QYS0313/FPGA_RACE_Lingmou/Software/Host_Software/Screenshots/model_detail_pose.png

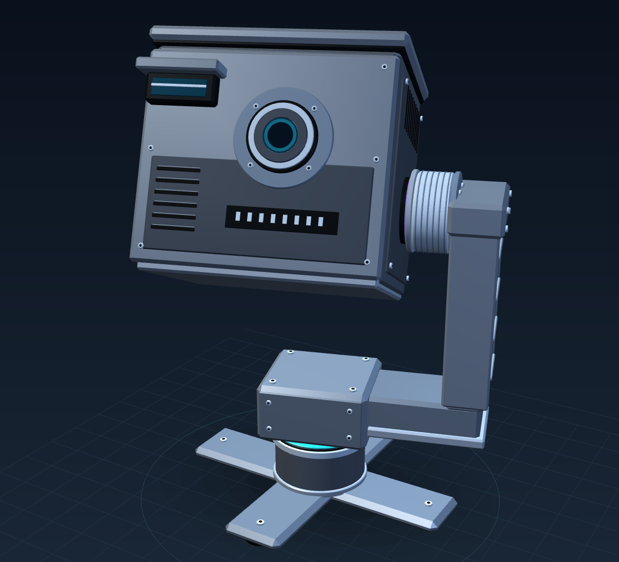
Software/Host_Software/Screenshots/model_detail_pose.png
