QYS0313/FPGA_RACE_Lingmou/Software/README.txt

FINAL FPGA DEMO DELIVERY - 2026-10-30

FPGA_Projects: Video_D1 (D1/A9) and Tracking_D2 (D2/E7), including source projects and final bitstreams.
Host_Software: integrated desktop console with bundled runtime. Start Launch_GUI.cmd.

两个正式工程与上位机已分开整理，目录和文件名使用英文。
工程一 TD 入口：FPGA_Projects/Video_D1/td_project/camera_to_dsi_display.al
工程二 TD 入口：FPGA_Projects/Tracking_D2/td_project/camera_to_dsi_display.al
上位机入口：Host_Software/Launch_GUI.cmd
原开发目录保持原样。未执行烧录、串口连接或电机控制。
SHA256SUMS.json records the packaged files for integrity verification.
