QYS0313/FPGA_RACE_Lingmou/Software/FPGA_Projects/Video_D1/README.txt

Video_D1 / A9

Open td_project/camera_to_dsi_display.al with Anlogic TD 6.2.1.
Final verified build: Bitstreams/demo_video.bit
Device: PH1P35MDG324.
Sources and constraints are included. Old generated databases are omitted.
Build_Report.txt records the shipped bit, not a future rebuild.
