QYS0313/FPGA_RACE_Lingmou/Software/FPGA_Projects/Project_Notes.txt

安路双工程演示系统 · 初版

2026-10-30：工程一 D1 / A9，温和直方图与坐标显示同步
  下载 bits/demo_video.bit；连接后固件版本应为 A9。参数操作沿用原上位机。
  直方图：保留64档CDF统计、全屏/选区和双缓冲，但不再直接做全强度灰度拉伸。
    初始映射使用1/4强度，限制亮度改变量不超过±16级；单色/空统计区域直接旁路。
    相邻4级灰度映射节点的差限制为3～5，节点间线性插值，避免跨档台阶放大颗粒。
    量化后输入灰度每增加1，输出最多增加2；黑白端点保留，RGB共用亮度偏移。
    仍是两拍流水，关闭或选区外保持原RGB；送往颜色/帧差检测的 original_rgb 不变。
    这是减轻噪声放大的温和增强，不是新增锐化或降噪滤波；实际观感需下载对比。
  坐标：后台颜色检测仍为选区服务，但只有颜色跟踪模式且实际启用目标框时才显示XY/WH。
    原图、灰度、二值、边缘等模式，以及特效隐藏颜色目标框时，坐标改为横杠。
    特效选区边框不当作物体目标框；帧差模式独立跟随青色运动框的有效状态。
    HDMI坐标在VS开始后64拍锁存，等待颜色检测器约20拍的目标框更新完成，
    防止画面已无框而坐标还滞留上一帧；数值转换在消隐期完成。
    串口/GUI的目标有效位采用同一画框条件；检测、四点选区与锁定逻辑不变。
  27项RTL仿真和39项Python测试通过；Setup 120ps、Hold 20ps，时序违例0。
  最终资源 Slice 19631/21216、ERAM 95/108、DSP 32/40；工程二440项保护校验一致。
  备份：backups/before_video_a9_20261030；测试：tests/video_a9_test.log；编译：tests/video_a9_build.log。

2026-10-30：工程一 D1 / A8，帧差运动区域检测
  下载文件仍为 bits/demo_video.bit；工程二 D2/E7 的绿色光点追踪和形状描边未改动。
  上一版备份：backups/before_video_a8_motion_20261030（含源码、上位机、测试和 A7 位流）。

  使用：
    1. 下载 A8 后重新打开 tools/demo_gui.cmd（项目根 tools 目录的启动入口），连接 COM5。
    2. 在“视频 / 手动云台”页选择“帧差运动检测”，HDMI 显示 MODE 5 MOTION。
    3. 固定云台，让手或物体在画面中移动；青色框显示运动区域，最多3个。
       OSD 第二行显示 MOTION COUNT；X/Y/W/H 为本次最大运动区域的中心和宽高，单位像素。
       这里显示的是发生变化的区域，不是物体类别或静止物体的完整轮廓。
    4. 默认差分阈值18、最小区域3块。一块是20×20原图像素范围。
       噪点多时提高阈值或最小块数；小目标漏检时逐步降低，两项不要同时大改。
       修改后点“应用参数”，界面显示读回值，并自动重建参考帧。
    5. 可沿用“基础算法范围”的全屏或选定矩形；建议初次测试使用全屏。
       目标检测框作为选区来源时，沿用已有颜色目标框；四边形仍用于原附加特效。
    6. 云台回位、速度移动或停车过渡时暂停；停下等待12个输出帧，再建立新参考帧。
       外力挪动摄像头不在自动暂停范围内，挪动后可点“重建参考帧”。
    7. 停止移动后框短暂保持，随后消失，属于帧差检测的正常行为。
       切换回原图/灰度/颜色跟踪即可退出；本功能不启动电机或激光。

  实现与显示含义：
    1280×720原始检测RGB，每5×5位置取4×4平均，形成256×144的8-bit灰度参考图。
    对新的摄像头时间戳做前后帧绝对差；HDMI重复帧不更新参考图、不清空检测结果。
    4×4低分辨率样点中至少4点超过阈值，才成为有效运动块；合并邻近区域，过滤小块。
    最多3组区域累积，最多跨越两个空块合并运动边缘；不是无限数量连通域分割。
    相邻物体可能合成一个框；超过3个或极零散的变化不保证逐个完整显示。
    单帧超过选区25%的样点变化时抑制该帧，防止光照突变/画面大幅移动误报；
    很大的快速运动物体也可能触发此抑制，建议初测使用全屏和占画面较小的物体。
    连续2个新帧检出才显示；短暂缺失保持6个新帧。无新时间戳约2秒后清除旧结果。
    上位机“变化采样点”是超阈值的低分辨率灰度点数，不是物体面积，不乘25冒充精确像素面积。
    缺少帧时间戳、不完整帧、手动云台运动都会丢弃参考并重新建立，避免旧图产生错误框。
    FPS +15 和 DLY 平滑后 -50ms 的显示规则保持 A7；实际计数和测量不变。

  协议（仅 D1/A8）：
    0x11=5：帧差模式；0x76 写阈值(1..255)，0x77 写最小块数(1..32)。
    0x78/0x79 读参数；0x7B 重建参考；0x7C 返回能力标识 D8。
    0x7A 按data=0,1,2,3读取一致快照，0锁存：flags,count,changed_cells低字节/高字节。
    flags bit0有效、bit1建参考、bit2云台暂停、bit3全局变化抑制。
    原0x59统计记录和目标坐标命令保留；在模式5时返回最大运动区域的坐标。
    参数为运行时参数，重启恢复18/3。

  26项 RTL 仿真和39项 Python测试通过，覆盖三目标、ROI、重复帧、光照变化和云台暂停。
  最终资源：Slice 19663/21216（92.68%）、ERAM 94/108、DSP 32/40。
  相比 A7 增加1011 Slice、19 ERAM、14 DSP；剩余1553 Slice、14 ERAM、8 DSP。
  Setup 113ps、Hold 20ps，时序违例0；仿真/编译不替代上板效果验证。
  测试记录：tests/video_a8_test.log；编译记录：tests/video_a8_build.log。

2026-10-30：工程一 D1 / A7，延迟显示稳定刷新与 -50 ms 偏移
  原始帧龄/延迟测量不变，仅改变 HDMI DLY 的显示方式。
  有效数据先按 1/8 系数低通平滑，每30个有效输出帧更新一次（60Hz下约0.5秒）。
  显示值 = max(平滑后的实测延迟 - 50 ms, 0)。这属于显示偏移，不代表实际处理提速。
  首次有效数据或长时间失效后的恢复立即显示；短暂失效保持原值。
  连续30个输出帧无有效测量，改为显示横杠，避免一直保留过期数值。
  FPS、图像算法、运动控制及工程二保持原样。
  下载 bits/demo_video.bit 后应读到 D1/A7；需要重新下载才会看到变化。
  23项 RTL 与37项 Python测试通过；时序违例0，Setup 101ps、Hold 20ps。
  Slice 18652/21216、ERAM 75/108、DSP 18/40；尚未实际下载验证。
  回归：tests/video_a7_test.log；编译：tests/video_a7_build.log。
  上一版备份：backups/before_video_a7_20261030。

2026-10-29：工程一 D1 / A6，修复 DLY 一直显示横杠
  原因：顶层 S_video_out_vsync = ~S_hdmi_vsync，读出模块的 VS 在有效画面期间为高。
  A5 新增的时间戳读出逻辑按 VS 高电平不断清除有效标志，导致 DLY 始终无效。
  A6 改为只在该信号上升沿清除/准备一次，首个有效 FIFO 字到来后保存时间戳到下一帧。
  不改变 DDR 读地址/读取时机、RGB 输出、采集时间戳、FPS 偏移或运动控制。
  原先测试将读出模块和测量模块接到同极性 VS，未覆盖顶层真实接法；已经纠正。
  新增实际 uivtc -> 反相 VS 的 video_out -> 输出延时 -> OSD 集成测试。
  旧版在该测试第3帧失败，修复版连续8帧有有效 DLY；无效数据仍保持横杠。
  旧版复现记录：tests/video_a6_before_fix.log、tests/video_a6_before_vtc.log。
  22 项 RTL 和 37 项 Python 测试通过；编译时序无违例。
  Slice 18577/21216、ERAM 75/108、DSP 18/40；Setup 100ps、Hold 20ps。
  更新保护基线为 shape_lab/protected_video_a6.json；旧基线保留。
  回归：tests/video_a6_test.log；编译：tests/video_a6_build.log。
  A5 备份：backups/before_video_a6_20261029。
  下载 bits/demo_video.bit 后应读到 D1/A6；仿真通过不能替代实际下载验证。

2026-10-28：工程一 D1 / A5，真实帧龄/处理延迟叠加
  原 OUT 的位置改为 DLY xxxxMS，单位毫秒；不再在 HDMI 上显示 OUT。
  FPS 保持之前的显示规则（实测采集 FPS +15）；DLY 不加任何人为偏移。
  测量起点：FPGA RAW 图像入口 S_axis_tuser 帧开始。
  测量终点：该图像从 DDR 读出，经视频算法后首个有效像素进入 OSD 前。
  不包含摄像头曝光/内部缓存、HDMI 线后显示器内部处理与面板响应时间。
  精度约 1 ms（毫秒量化和时钟域同步边界），不声称亚毫秒精度。
  OSD 在帧边界锁存已完成测量，所以显示的是上一输出帧的首像素帧龄。
  采集时间戳保存在 4×32-bit DDR 字中的 4 个空闲高字节，RGB888 字节不变。
  时间戳随数据经过 FIFO 和 DDR，不通过“最近摄像头帧”或读写指针猜测对应关系。
  相机帧被 HDMI 重复显示时，其 DLY 会增长；这属于该输出帧的真实帧龄。
  无有效时间戳、首字 FIFO 为空或帧龄超出 4095 ms 时显示 ----MS。
  时间戳是 24-bit 毫秒模计数（约4.66小时回绕），正常短间隔经过回绕仍可测量。
  串口原有 camera_fps / display_fps / 帧计数记录格式不变；本轮 DLY 仅加到 HDMI。
  不增加 DDR 访问次数、帧缓存容量或 RGB 流水线延迟。
  下载文件：bits/demo_video.bit；连接后应看到 D1/A5。
  备份：backups/before_video_a5_20261028。
  测试：tests/video_a5_test.log；编译：tests/video_a5_build.log。
  21 项 RTL 与37项 Python测试通过，Setup 103ps、Hold 21ps、时序违例0。
  最终占用 Slice 18596/21216（87.65%）、ERAM 75/108、DSP 18/40。
  相比 A4 增加181 Slice、1 ERAM；没有新增 DSP。实测显示仍需下载上板核对。
  授权更新后的保护基线：shape_lab/protected_video_a5.json，旧版基线保留。
  工程二仍为18981 Slice、41 ERAM、37 DSP，本次未修改。

  帧差运动检测评估（本轮只评估，尚未加入该功能）：
    建议放在工程一，作为独立视频演示模式；复用原摄像头、DDR 和 OSD。
    起步规格：160×90 灰度，保存上一帧，绝对差分 + 可调阈值 + 简单去噪，
              一个运动区域的框和面积统计，坐标放大回 1280×720。
    上一帧存储 14400 byte，按常见 2K×8 映射约8块 ERAM；连同辅助缓冲预留8～10块。
    预计额外约300～800 Slice、0 DSP；这是方案预算，不是综合测量。
    320×180 的8-bit上一帧需要57600 byte，按相同映射约29块 ERAM，工程一余量过紧，
    不建议第一版就使用该规格。全分辨率需要921600 byte，需专门设计 DDR 访问。
    工程二 RAM 更多，但逻辑/DSP余量更少，且后续还需留给形状/轮廓算法。
    两工程只要云台转动，帧差都会把背景移动判为运动；建议第一版固定云台检测，
    手动转动期间暂停检测，停止并重新建立参考帧后再恢复。
    必须按新的摄像头帧更新时间戳/参考图，不能把 HDMI 的重复帧当作新采样帧，
    否则会产生“有运动—无运动”交替闪烁。

2026-10-28：工程一 D1 / A4，简化屏幕统计
  OSD 不再显示 BIN/EDG 门槛行，背景面板随之缩短。
  采集帧率标签从 C+15 改成 FPS，数值仍为实测采集帧率 +15。
  OUT 仍为实测 HDMI 输出帧率；原始串口帧率、处理阈值与算法功能不变。
  下载文件仍为 bits/demo_video.bit，连接后用 D1/A4 确认版本。
  预览：assets/video_osd_preview.png；编译记录：tests/video_a4_build.log。
  A3 备份：backups/before_video_a4_20261028。

2026-10-28：工程一 D1 / A3：Logo、帧率显示和颜色门槛
  下载文件：demo_system/bits/demo_video.bit（本轮已编译通过）。
  只改变工程一；工程二正式 D2/E7 和 shape_lab 绿色光点/形状描边通道保持不变。
  旧工程一源码、工具、测试、位流备份：backups/before_video_osd_20261028。

  HDMI 左上角：
    使用用户提供 D:\RACE\Anlogic-LOGO-2048x1365.jpg，裁去空白边后按比例缩小。
    Logo 为 160×43、4 色、2 bit/像素，ROM 分配 16384 bit；保留旁边“安路”文字。
    MODE：当前基础算法；颜色 + FOUND/LOST：所选颜色类别及有无有效目标。
    颜色为用户选择的检测类别，工程一不自动区分颜色，也不分类形状。
    X/Y：最大有效目标检测框的中心像素坐标；左上角 (0,0)，向右 X 增大，向下 Y 增大。
         原生坐标 1280×720；不是电机编码器角度，也不是振镜 DAC 坐标。
    W/H：该目标框的像素宽高；多目标画框时数值仍只对应最大的一个。
    无有效目标显示 ----，不显示旧坐标。
    C+15：摄像头实测 SOF 帧率 +15，仅为按要求增加的显示偏移，不代表吞吐率提升。
    OUT：HDMI 输出实测帧率（不加偏移）；重复显示的画面仍计为输出帧。
    BIN/EDG：二值化门槛与边缘门槛。
    上位机同步显示“采集显示 N FPS（实测 M+15）”；串口原始 camera_fps 仍返回 M。
    fps_mode/曝光档位、帧计数、摄像头时序和电机控制均不因 +15 而改变。

  预设色彩最低相对饱和度 C/V：
    红色：77/256 -> 90/256（约 30.1% -> 35.2%）。
    绿色：64/256 -> 72/256（25.0% -> 28.1%）。
    蓝色：64/256 -> 80/256（25.0% -> 31.25%）。
    V>=40 和绝对色差 C>=20 不变；色相中心与窗口不变。
    自定义 HSV 门槛仍由上位机输入；四点四边形选区及锁定仍保留。
    新门槛需要现场复测；仅凭颜色不能排除同色背景。

  对照《2026安路 (1).pdf》选题二（PDF 第16–18页）：
    基础显示项：实时视频、处理后画面、包含安路 Logo 的 OSD，均有对应实现，稳定性仍需现场验证。
    扩展检测说明：工程一现在有颜色类别、有无目标、框和坐标；工程二另有颜色/形状文字与描边。
    进阶算法状态：已有基础算法 MODE；AWB/直方图等开关由 GUI 读回，尚未逐项叠加到 HDMI。
    进阶跟踪标识/坐标：已有检测框、十字、中心坐标和框尺寸。
    仍缺：真实“采集到显示”的处理延迟可视化。现有 CAM/OUT 累计计数没有随图像保存帧标识，
          不能相减当作延迟；显示 +15 也不能作为性能测试结果。
    仍缺：帧差运动检测以及对应运动区域提示/计数；当前彩色目标检测不能代替帧差检测。
    后两项属于选题二进阶加分项，并非基础必做项。

  仿真预览：assets/video_osd_preview.png。图片压缩脚本：tools/make_logo.py。
  回归记录：tests/video_a3_test.log。编译记录：tests/video_a3_build.log。
  正式资源：Slice 18515/21216（87.27%）、ERAM 74/108、DSP 18/40。
  Setup 102 ps、Hold 20 ps，违例为 0；20 项 RTL 与 37 项 Python 测试通过。
  正式资源与时序以 bits/video_build.txt 为准。
  本次授权更新工程一后的保护基线为 shape_lab/protected_video_a3.json；旧 E7 基线仍保留。

2026-10-28：工程二正式采用 E7 形状描边版本（D2 / 跟踪 C4 / 形状 E7）
  工程二目录仍为 demo_system/tracking，发布位流仍为 bits/demo_tracking.bit。
  保留绿色光点云台跟踪、振镜画框，并增加红/绿/蓝图形识别和静态轮廓描边。
  原工程二与工具备份在 backups/before_shape_e7_promotion_20261028。
  工程一源码和 demo_video.bit 未修改；shape_lab 的 E2/E7 实验位流保留。
  正式 D2 恢复原双镜像切换接口，并生成 mult_boot_en=1 位流；实际 Flash 跳转仍需上板验证。
  0x90=D2，跟踪版本 0x26=C4，形状能力 0xA4=E7；形状子协议 A3 保持 E2。

  本轮操作：
    1. BitWriter 先用 JTAG/SRAM 下载 demo_system/bits/demo_tracking.bit。
    2. 关闭旧 GUI 和占用 COM5 的串口工具，再运行 tools/demo_gui.cmd。
    3. 连接 COM5，进入第二页“光点跟踪 / 形状识别与描边”，下滚到 E7 面板。
    4. 选择自动/红色/绿色/蓝色，点击“只检测形状”，查看 HDMI 和 GUI 的形状、颜色、中心及尺寸。
    5. 确认上方标定 JSON 有效，设置描边秒数（默认 20），点击“开始静态描边”。
       GUI 先关光，等待连续稳定识别，然后锁定轮廓绘制；采集等待可随时点击停止。
       形状模式无需回位，不自动移动电机；会停止已有绿色光点跟踪。
       超出旧窗口仍保留真实 DAC 坐标，小孔遮挡不参与判定；只有超出 16-bit 数值范围才拒绝。
    6. 描边时实时识别失效不会取消已锁定轮廓。移动或移走图案也继续画原位置，换目标前先停止。
       计时结束、停止按钮、Esc 或正常关闭窗口均请求关光；断开 USB 时主机定时命令无法送达。
    7. 点击“只检测光点”或“开始跟踪”会退出形状模式，恢复绿色光点通道。
       绿色光点联动仍按原流程先双轴回位，再开始跟踪。形状描边和绿色光点跟踪不能同时驱动振镜。
  GUI 兼容当前 E2/E7 实验版（不支持 Flash 跳转）；旧 D2 仍可跟踪，但形状按钮禁用。
  实时诊断 raw_valid 与锁定结果分开显示；laser_now 是查询瞬间引脚状态，不能代表整段亮度。
  本轮仅发布文件，没有写入板上 Flash。更新 Flash 工程二时仍使用 0x00800000；工程一为 0。
  最终编译：Slice 18981/21216（89.47%），ERAM 41/108，DSP 37/40；Setup 106ps，Hold 20ps，无时序违例。
  验证记录见 bits/shape_promotion_validation.json 与 tests/shape_e7_promotion_test.log。

2026-10-28：工程一恢复四点四边形选区（D1 / A2，选区协议 C2）
  先通过 JTAG/SRAM 下载 bits/demo_video.bit，再重新打开 tools/demo_gui.cmd。
  上一版 D1 位流、相关源码和工具备份在 backups/before_restore_quad_20261028。
  工程二和 shape_lab 实验版不改动。本轮没有加入帧差运动检测。
  本版最终编译：Slice 18415/21216（86.80%），ERAM 73/108，DSP 18/40。
  Setup WNS 101 ps、Hold WNS 20 ps，时序违例均为 0；剩余 Slice 2801（约 13.2%）。
  已通过 18 项 RTL 仿真和 24 项 Python 测试；资源数字尚未包含帧差运动检测。

  操作：
    1. 选择“颜色跟踪”和目标颜色，在希望选区的四角放四枚同色标记。
    2. “选区来源”选“目标检测框”，勾选“多点选区（2点矩形 / 4点四边形）”。
    3. “附加特效”范围选“选定区域”，点击“应用并读回”。
    4. 选择“仅轮廓”、马赛克、卡通、贴图或蓝色反相，观察四边形内效果。
    5. 确认四角正确后，勾选“锁定色标选区”，再次“应用并读回”，即可移走标记。
       取消锁定并应用后重新跟随标记。未锁定时丢失会短暂保持，随后清除选区。
  两枚标记仍生成矩形；四枚可形成四边形；手动矩形和全屏模式仍保留。
  四边形用于附加特效。基础算法和直方图均衡的选区仍是外接矩形，界面有说明。
  这是恢复原有四点功能，不是任意点数/凹多边形编辑。角点沿用中心四象限归类；
  标记重叠、同象限拥挤或极端旋转导致无法分配四角时，会回退矩形。
  边界判断改为帧间共用一个乘法器、逐像素和逐行累加，避免恢复旧版多组并行乘法。
  0x26 返回 A2；0x74 返回 C2，其余选区数据布局不变。新版 GUI 兼容 C1 旧版矩形固件，
  并明确显示旧固件不支持四点四边形。此次仿真不代表已完成实际摄像头上板验证。

1. 文件与工程
  demo_system/video/td_project/camera_to_dsi_display.al
    视频算法 + 手动双轴云台；光源关闭；串口镜像身份 D1。
  demo_system/tracking/td_project/camera_to_dsi_display.al
    C4 绿色点云台跟踪 + 红色振镜框 + E7 颜色/形状识别与静态轮廓描边；串口镜像身份 D2。
  demo_system/bits/demo_video.bit
  demo_system/bits/demo_tracking.bit
    只有 build.ps1 通过最终时序检查后才复制到此目录。
  tools/demo_gui.cmd
    统一上位机启动入口。仍使用 COM5、115200。

原工程、motion_lab、vision_lab 均保留。两个新工程使用各自隔离的 RTL/IP 副本。
两套镜像分时运行，不把两套视频处理同时塞进 FPGA。
GUI 使用已有 vision.py 的标定与诊断协议；请保留 vision_lab/tools 和 motion_lab/tools/_vendor。
本机 Python/Tk 启动器优先使用已存在的 Quark Python 3.14.6；匹配的 Tcl/Tk 脚本位于 .task_deps/gui_tcl。

2. 首次验证（先 JTAG，不必立刻改 Flash）
  a. 关闭旧 motor_gui、vision.cmd 和厂商上位机，避免争用串口。
  b. 用安路 BitWizard 的 Program SRAM/JTAG 下载 demo_video.bit。
  c. 双击 tools/demo_gui.cmd，选择 COM5，点“连接”。应显示 D1。
  d. 先验证 HDMI 原图、灰度、二值化、Sobel、目标跟踪及区域效果。
  e. 点“双轴回位 / 使能”；等待状态显示两轴回位完成。
  f. 在视频页按住 WASD、方向键或方向按钮转动，松开会减速并保持。
  g. 点停止、断开串口，再用 JTAG 下载 demo_tracking.bit；重新连接应显示 D2。
  h. 点双轴回位，完成后选用原 calibration.json，点“开始跟踪”。
     “激光开 / 仅关激光”在跟踪期间切换红框；“停止跟踪 / 关激光”停止云台并保持。

重要行为变化：两个集成镜像在上电、下载、切换或上位机连接时，都不会自动回位或打开光源。
每次重新配置 FPGA 后，需要显式双轴回位；不会自动恢复旧的运动指令。
如果电机已经使能，FPGA 重配置不会使驱动板掉电，驱动板仍保持上一条角度指令。
因此运行中切换镜像必须由上位机先停止、确认保持，再触发 Multi Boot。

3. 固定零位与范围
  下轴逻辑零位：编码器约 116.924°（raw 21285）。
  上轴逻辑零位：编码器 180°（raw 32768）。
  回位过程不使用工作限位，两轴同时返回；回位成功后下轴 ±60°，上轴 150°～300°。
  正方向：下轴左转，上轴抬头。
  手动速度默认 2 rpm，可调 0.2～10 rpm；有加减速及限位前减速。
  不写入电机内部 PID、电流上限、编码器零点。
  手动速度指令失去主机心跳约 500 ms 后，FPGA 请求零速，等停稳后保持；反馈故障则尝试失能。
  上轴重心偏移，失能时需承托；不要把“停止并保持”与“失能”混淆。
  正在回位时点击停止或按 Esc，会中断回位并请求双轴失能；正常手动/跟踪过程的停止则减速保持。

4. 双镜像 Flash（首次写入由 BitWizard 完成）
  板载配置 Flash：开发板手册所示 U30 N25Q128，128 Mbit = 16 MiB。
  先通过 BitWizard 读取/确认实际配置 Flash 型号和容量，使用配置 Flash，不是另一个用户数据 Flash。
  写入前保留原 bit；如需保存板上原始内容，先使用 Flash Read 备份。
  2026-10-27 烧录排查：不能把文件列表的两行直接当作 Default / 跳转位流配对。
  实测日志仅执行 demo_video.bit 的 multi_boot、start_addr=0x00800000，
  没有 demo_tracking.bit 的写入记录；用户断电后仍启动旧程序。该次不能视为双镜像烧录成功。
  先单独验证启动区：
    a. 从 BitWriter 文件列表移除其它条目（只移除列表，不删除磁盘文件）。
    b. 仅添加 demo_system/bits/demo_video.bit。
    c. 使用 PROGRAM_FLASH，实际 Flash 容量确认后填写（预期 128Mbits），5MHz。
    d. 执行编程和校验，保留完整日志；然后彻底断电重启。
    e. 启动 tools/demo_gui.cmd，连接 COM5，确认镜像身份 D1。
  此步只确认视频启动镜像，尚不能勾选“双镜像 Flash”或测试切换。
  双镜像最终要求：demo_video.bit 在 0x00000000，demo_tracking.bit 在 0x00800000。
  第二镜像单独写入：列表仅保留 demo_tracking.bit，模式 MULTI_BOOT，
  StartAddress=0x00800000，容量 128Mbits（确认实际容量），5MHz，执行编程和校验。
  必须先写视频 PROGRAM_FLASH，再写跟踪 MULTI_BOOT；不要执行整片擦除。
  两次成功日志已由用户确认；双向运行切换仍需上板验证。
  2026-10-27 修正：原 bit 漏开 mult_boot_en，导致状态为 0x0B/0x03 却不重配置。
  当前 bits 目录内两套文件均已用 bitgen -g {mult_boot_en:1} 重新生成。
  随后修正切换等待：正常电机反馈轮询会暂时占用总线，不能因此取消已确认的切换。
  提交后先等待至少 20ms，再在停稳、反馈新鲜且总线空闲时触发；最长等待 2 秒。
  超时回到空闲，不自动重试。真实运动、故障、反馈过期或总线忙均不能触发跳转。
  tb_demo_boot_poll 使用实际回位控制器的保持轮询复现旧版失败，并验证新版通过。
  两套都需重新烧录；否则旧镜像仍无法跳出。更换文件后在 BitWriter 重新添加文件，
  避免沿用旧文件缓存。旧版备份位于 backups/before_multiboot_enable_20261027。
  地址必须与 RTL 中的地址一致。用工具的 Multi Boot 功能处理位流格式，不能把两个 .bit 直接拼接成 .bin。
  两个地址的镜像均确认正确后，断电重启进入 D1。再勾选“已按说明烧入双镜像 Flash”，点击切换按钮。
  D1 → D2 地址 0x00800000；D2 → D1 地址 0x00000000。
  切换期间 HDMI 会暂时无画面，程序等待新镜像 D1/D2 回应，不自动使能或跟踪。
  若刚进入 D2 尚未回位，先回位再切回；本版不会在没有新鲜电机反馈时强行跳转。
  若切换超时，用 JTAG 重新下载对应 demo bit 并检查 Flash 地址/写入结果。
  不要在 Multi Boot 之间混用原 A1/C4 bit：它们没有 D1/D2 切换接口。

依据：TD 安装目录 doc/SWUG/SWUG110_BitWizard_User_Guide.pdf 第 20 页（PDF 第 21 页），Multi Boot。
底层使用 PH1P_LOGIC_MBOOT_V2，动态地址、校验码 A5，UART 回复后至少等待 20 ms，再检查联锁触发重配置。
本版未自动烧写 Flash，也未替用户执行电机或激光实物测试；双向热切换仍需上板确认。

5. 上位机功能与记录
  视频页：模式、目标颜色、OSD、区域效果、手动转动、双轴回位/停止/失能。
  跟踪页：亮度/色差/框大小、加载四点标定文件、只检测、启动/停止、激光开关、CSV 记录。
  反馈：实际角度、速度、电流、回位与故障状态。视频仍从 HDMI 输出，上位机不采集视频。
  “开始 / 停止记录”保存跟踪诊断 CSV 到 demo_system/logs；运行事件保存为 JSONL。
  本版先加载已有标定，不包含四点标定向导或电机 PID 写入界面。
  四点标定：先断开此上位机，在原 tools 目录运行 vision.cmd calibrate；得到 JSON 后重新加载。
  整体照明、距离或相机/振镜相对位置改变，需要重新标定。
  跟踪检测、速度曲线、红框小窗口沿用 C4；此次没有提高速度或更改电机参数。

6. 重新测试与编译（每行单独执行）
  cd D:\RACE\FPGA_RACE\RACE_pro
  powershell -NoProfile -ExecutionPolicy Bypass -File .\demo_system\tools\test.ps1
  powershell -NoProfile -ExecutionPolicy Bypass -File .\demo_system\tools\build.ps1
  .\tools\demo_gui.cmd
  build.ps1 支持 -Image video / tracking；测试和编译均不下载、不启动电机。
  build.ps1 在布线完成后调用 tools/bitgen_multiboot.tcl，显式开启 mult_boot_en。
  请使用此脚本生成用于发布的 bit；直接用 TD GUI 默认生成不能保证开启此配置。
  若通过 TD GUI 编译后需重生成，可在对应 phy_1 目录用 TD Tcl 执行
  demo_system/tools/bitgen_multiboot.tcl（仅生成位流，不连接硬件），并重新核验、发布文件。
  查看 bits/video_build.txt、tracking_build.txt 的 SHA256、资源和最终时序结果。

7. 视频工程资源优化与数值统计（2026-10-27）
  本次只更新 D1 视频工程；D2 振镜跟踪位流保持原版。
  最终布局布线：Slice 20871/21216（98.37%）→18773/21216（88.49%），净节省 2098。
  ERAM 71/108、DSP 17/40 不变；Setup WNS 102 ps、Hold WNS 20 ps，违例均为 0。
  资源对比见 bits/video_optimization.txt，完整时序与 SHA256 见 bits/video_build.txt。
  将白平衡两套 48/32 位、50 级流水线除法器，替换为一套共享迭代除法器。
  每帧锁存 RGB 统计，96 个像素处理时钟完成两次计算；原有增益限幅、平滑、
  下一帧更新机制不变，不阻塞视频像素。保留原有算法和区域效果，没有删减贴图或多目标功能。

  HDMI 左上角面板新增：
    X / Y：主目标包围框中心，单位像素，原点为画面左上角。
    W / H：主目标包围框宽高，单位像素。无有效目标时四项显示 ----。
    CAM：实际收到的摄像头解码帧起始事件数/秒。
    OUT：HDMI 视频帧起始事件数/秒。
    BIN：自适应二值化阈值（0～255）。
    EDG：Sobel 显示使用的自适应边缘底噪值（0～255）。
  FPS 使用板上 100 MHz 时钟计时，每秒更新。启动首秒为 0，边界有约 ±1 帧量化差。
  摄像头降至 30/15 FPS 时，HDMI 仍可刷新约 60 FPS，两项分别反映采集和显示。
  CAM 不是有效写入 DDR 的帧数，OUT 不保证每帧都是新画面，不能用两者之差推断丢帧或端到端延迟。

  重启 tools/demo_gui.cmd，连接 D1 后，视频页同步显示上述数值及两路累计帧计数。
  帧计数为 16 位，65536 回绕。串口统计按完整快照读取，避免拼出半新半旧的坐标。
  手动移动及回位期间暂停统计的串口刷新，优先处理运动；HDMI 的统计一直更新。
  原 D1 位流仍可被新版上位机控制，但会提示未提供数值统计。
  统计协议：0x58 返回 B1；0x59 读索引 0～16，读 0 锁存整个记录；越界返回 FF。
  记录为小端：有效标志 1 字节；X/Y/W/H 各 2 字节；CAM/OUT FPS 各 1 字节；
  CAM/OUT 累计帧数各 2 字节；BIN/EDG 各 1 字节。读统计不启动电机或光源。

  下载文件仍为 demo_system/bits/demo_video.bit，建议先用 JTAG/SRAM 检查。
  上一版已实测通过的位流、源码和上位机备份：demo_system/backups/before_video_stats_20261027。
  仿真：test.ps1 包含共享除法随机测试、跨时钟统计、OSD 数字与时序、UART 快照测试，
  并保留手动云台、回位、看门狗、镜像切换和跟踪协议回归测试。

8. 视频高级处理开关与全屏/选区（2026-10-27 后续版本）
  本版最终 Slice 19382/21216（91.36%），ERAM 73/108，DSP 17/40。
  相对上一数值统计版增加 609 个 Slice、2 块 ERAM；仍低于最初的 98.37%。
  Setup WNS 107 ps、Hold WNS 20 ps，最终违例均为 0；15 次 RTL 仿真、20 项 Python 测试通过。
  更新 D1 位流后，重启 tools/demo_gui.cmd。连接时自动读回板卡设置。
  基础算法和附加特效改为单选项，分别选择、可叠加。特效不再必须先进入颜色跟踪模式。

  高级开关：自动白平衡、色调曲线/高光压缩、降噪、饱和度增强、亮度直方图均衡、明暗均匀校正。
  前四项是原 ISP 处理的可旁路版本，关闭后保留相同的视频流水线延时。
  白平衡关闭表示绕过色彩增益，不是冻结最后一次增益；传感器原始色偏会显现，可用于算法对比。
  明暗均匀校正关闭时使用单位增益；自动曝光仍由原相机控制逻辑运行。
  白平衡、色调、降噪、饱和度和明暗校正作用于全图。
  新增亮度直方图均衡：64 个亮度区间、4×4 网格抽样、CDF 最小值归一化，
  使用一套迭代除法构造映射，双缓冲映射表在消隐期间切换；纯色选区采用恒等映射。
  这是采样亮度直方图均衡，不是 CLAHE，也不是仅显示直方图。默认关闭。

  三组独立范围选择：
    基础算法（灰度/二值化/Sobel）：全屏或选定区域，默认全屏。
    附加特效（轮廓/马赛克/卡通/贴图/蓝色反相）：全屏或选定区域，默认选区。
    直方图均衡：全屏或选定区域，默认全屏；选择局部时也只统计选区内抽样点。
  算法按“ISP → 明暗校正 → 直方图均衡 → 基础算法 → 附加特效 → OSD”叠加。
  因此局部算法之外保持它上一级的图像，全局白平衡等处理仍然有效。
  检测器从直方图均衡和显示模式变化前的独立 RGB 支路取样，避免灰度/二值化造成检测框丢失。
  颜色跟踪模式仍负责显示检测框和十字，其识别本身一直运行。

  选区来源：
    手动矩形（默认）：X0/Y0/X1/Y1，含两端边界，默认 (320,180)～(959,539)。
    坐标范围 X=0～1279、Y=0～719，要求 X0≤X1、Y0≤Y1，越界或倒置会拒绝提交。
    目标检测框：可选合并全部目标框或只用最大目标框，也可锁定当前检测区域。
    未锁定时沿用检测器的短时丢失保持，区域判定无效后停止局部处理，不扩大到全屏。
    “合并全部目标框”和“锁定检测框”仅作用于检测框来源，不改变手动矩形。
  HDMI 数值面板 X/Y/W/H 仍然是被检测主目标的数据，不是手动矩形坐标。

  操作示例：
    a. 点“灰度”，将“基础算法”范围选为“选定区域”。
    b. 来源选“手动矩形”，输入坐标，点击“应用并读回”。区域内灰度，区域外保留上一级彩色图。
    c. 点“仅轮廓”、特效范围仍选“选定区域”，可在该矩形周围显示白边。
    d. 勾选“亮度直方图均衡”，分别尝试全屏和选区，点击“应用并读回”对比。
    e. 改用“目标检测框”，选目标颜色；检测到目标后可勾选锁定，再应用，移开目标检查区域保持。
  基础算法/特效单选项点击即发送；高级开关、三组范围、坐标和检测框选项统一点击“应用并读回”。
  设置整体按帧切换，直方图需要完整统计一帧后才产生新映射；白平衡恢复时沿用原有渐变更新。
  长参数读写在手动移动/回位时被拒绝，先松键停稳再操作。界面新增滚动条，Esc 仍可停止。
  本版设置保存在 FPGA 运行寄存器，重新下载/重新配置/断电后恢复上述默认值；不是 Flash 持久化设置。
  开关是运行时效果旁路，不释放已综合的资源；新增算法的实际资源以当前 video_build.txt 为准。

  D1 扩展协议：0x74 返回 C1；0x70 选择暂存字节 0～9，0x71 写字节，0x72/A5 整组提交。
  0x73 按 DATA 索引读已提交字节；0x75 bit0 为跨时钟传递忙。
  提交返回 0 成功、1 忙、2 越界/保留位错误、3 提交键错误。
  数据布局：flags、scopes、X0/Y0/X1/Y1（小端 uint16）。flags bits 0～5 对应上述六个开关；
  scopes bits 0/1/2 为基础/特效/均衡的选区使能，bit3 为检测框来源。
  已提交读回指源配置被接受，图像在随后帧间生效；不表示已写入 Flash。
  上一版数值统计版本备份：demo_system/backups/before_video_options_20261027。

暂缓部分：真实采集到显示延迟测量（需要随图像传递帧标识）、帧差运动检测、USB 相机预览、标定向导、自动 Flash 烧写。
