QYS0313/FPGA_RACE_Lingmou/Software/Host_Software/Reports/20261031_ui_update/console_1600_video.html

灵眸LINGMOU

工作空间

模型标定

◎

精密视觉控制VISION CONSOLE / 02

设备控制中心VISION CONTROL

工作空间/视频算法

离线演示连接设备

PRECISION IN MOTION

# 视频算法工作台.

视频算法切换 · 双轴姿态映射 · 图像增强与选区

本地工作空间模式选择

当前工作模式离线动作演示非设备反馈

DEMO

01

PAN 水平转轴142.90°+0.07 rpm0.210 A

演示数据

02

TILT 俯仰转轴190.06°-1.17 rpm0.207 A

演示数据

视觉目标等待检测相机画面从 HDMI 输出

## 双轴姿态趋势相对零位 / °

PANTILT最近 20 秒

连接设备后显示实际运动趋势

## 光点追踪控制

D2

视觉标定已加载

calibration.json点击更换标定文件

检测参数DETECTION

亮度阈值160 色差阈值40

光框半径

px

启动时开启激光框

双轴回位 / 使能↗ 开始光点跟踪

停止 / 关光双轴失能

仅检测光点仅关闭激光打开激光

颜色 / 形状识别E7⌄

目标颜色描边时长 / 秒

只检测形状开始静态描边

连接支持 E7 的工程后启用

等待连接

停止描边 / 关光

运行数据记录角度 · 转速 · 电流

记录

ASSEMBLY / DIGITAL TWIN

## 双轴姿态映射 装配体 02

离线演示 · 非设备反馈

载入精密装配体正在准备三维工作空间

02OPTICAL GIMBAL

双轴联动PAN × TILT

水平旋转 俯仰旋转

PAN+26.0°

TILT+10.1°

拖动旋转·滚轮缩放

ISOMETRIC VIEW

完整装配内部结构

演示动作 · 未控制设备停止离线演示

## 视频算法处理画面从 HDMI 输出

D1

01原始画面Original02灰度处理Grayscale03二值化Binary04Sobel 边缘Edge detection05颜色跟踪Color tracking06帧差运动检测Frame difference

## 图像增强与选区

读取设备参数 ↗

自动白平衡色调曲线 / 高光压缩降噪饱和度增强亮度直方图均衡明暗均匀校正

基础算法范围附加特效范围直方图范围

选区来源多点选区锁定色标选区

X0Y0X1Y1应用并读回

等待连接视频工程

## 视频实时统计

HDMI

等待设备采样

## 手动云台

PAN / TILT

运动速度

rpm

↑←→↓

按住方向键或 WASD，松开减速停车

双轴回位 / 使能

停止并保持双轴失能

## 附加特效与检测

附加特效目标颜色OSD 信息叠加

帧差阈值最小区域块数

应用参数重建参考帧

等待运动检测采样

控制台已就绪，等待连接设备

查看运行记录LOCAL / DEMO

ACTIVITY

## 运行记录

20:59:21控制台已就绪，等待连接设备

MODEL CALIBRATION

## 模型显示标定

设置模型的参考角度与显示方向。仅影响三维显示。

PAN 参考角度 / °显示方向TILT 参考角度 / °显示方向

保存显示标定

WORKSPACE

## 模式选择

软件切换依赖板卡已正确配置双镜像 Flash。

已按工程说明烧入双镜像 Flash

D1 视频 / 手动云台D2 光点跟踪 / 形状识别

{"passed":true,"checks":[{"name":"original_mesh_count","passed":true},{"name":"original_triangle_count","passed":true},{"name":"fixed_base","passed":true},{"name":"pan_hierarchy","passed":true},{"name":"tilt_hierarchy","passed":true},{"name":"internal_structure","passed":true},{"name":"assembled_structure","passed":true},{"name":"joint_rotation","passed":true},{"name":"webgl","passed":true},{"name":"encoder_wrap","passed":true},{"name":"video_workspace","passed":true},{"name":"video_model_visible","passed":true},{"name":"video_layout_width","passed":true},{"name":"video_mode_0","passed":true},{"name":"video_mode_1","passed":true},{"name":"video_mode_2","passed":true},{"name":"video_mode_3","passed":true},{"name":"video_mode_4","passed":true},{"name":"video_mode_5","passed":true},{"name":"video_selection_green","passed":true},{"name":"video_encoder_pose","passed":true},{"name":"shared_model_preserves_pose","passed":true},{"name":"tracking_model_restored","passed":true},{"name":"layout_width","passed":true},{"name":"no_script_errors","passed":true},{"name":"timeline_visible","passed":true},{"name":"local_control_channel","passed":true},{"name":"stop_button_visible","passed":true}],"errors":[],"preview":true,"source_sha256":"b57bcdbfbf650069a2fc20a358beccc8f75ff22d7335b0ab5236ae00bfef5911","viewport":{"width":1574,"height":1000,"timeline_bottom":959.1875}}
