QYS0313/FPGA_RACE_Lingmou/Software/Host_Software/Reports/20261031_ui_update/console_1600_video.png

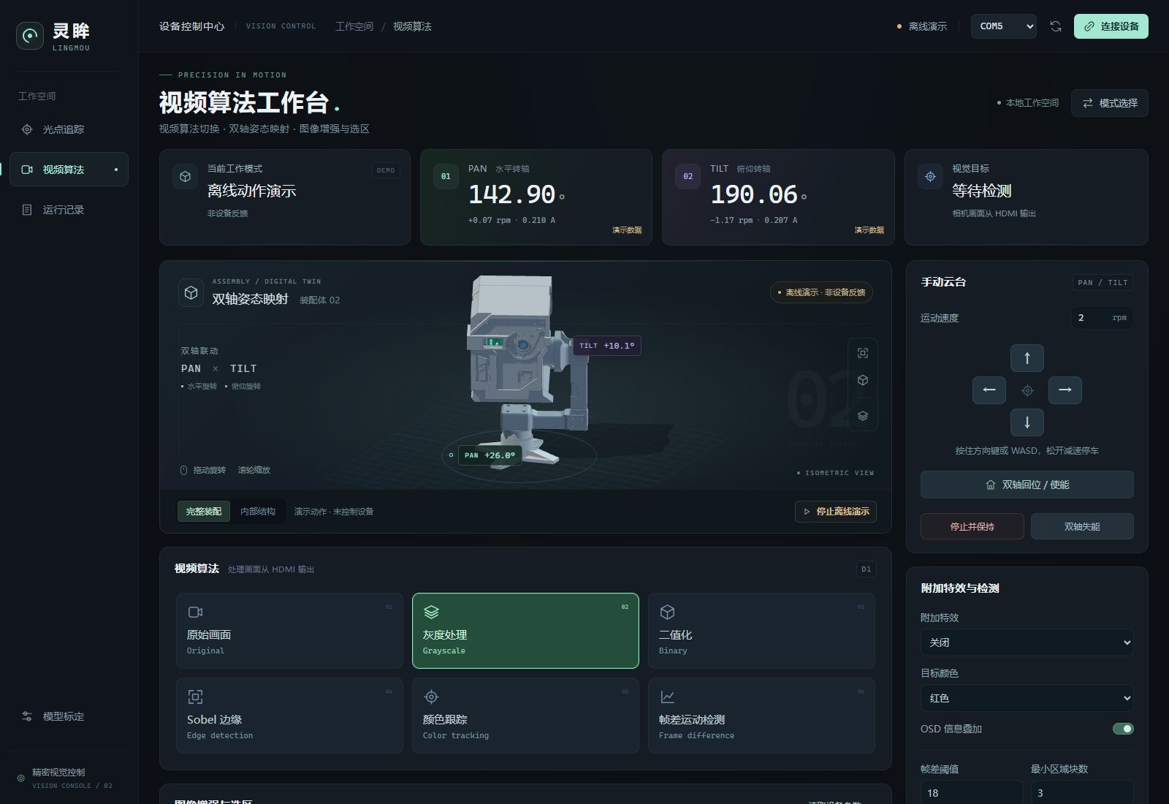
Software/Host_Software/Reports/20261031_ui_update/console_1600_video.png
