QYS0313/FPGA_RACE_Lingmou/Software/Host_Software/Screenshots/css_console_internal.png

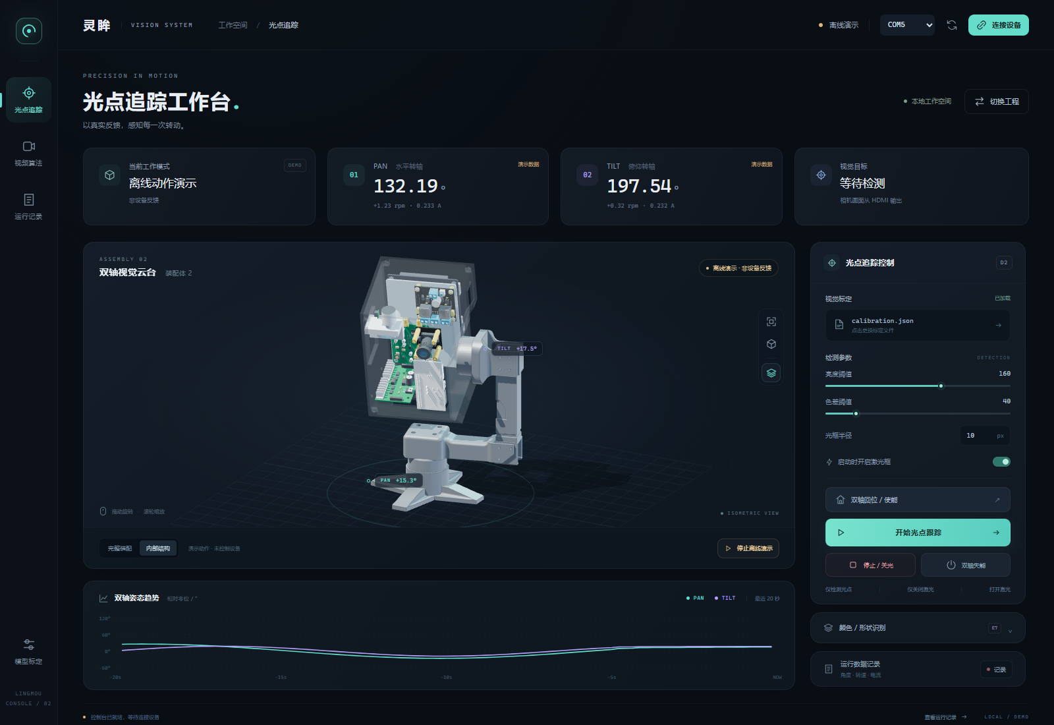
Software/Host_Software/Screenshots/css_console_internal.png
