QYS0313/FPGA_RACE_Lingmou/Software/Host_Software/Screenshots/model_detail_home.png

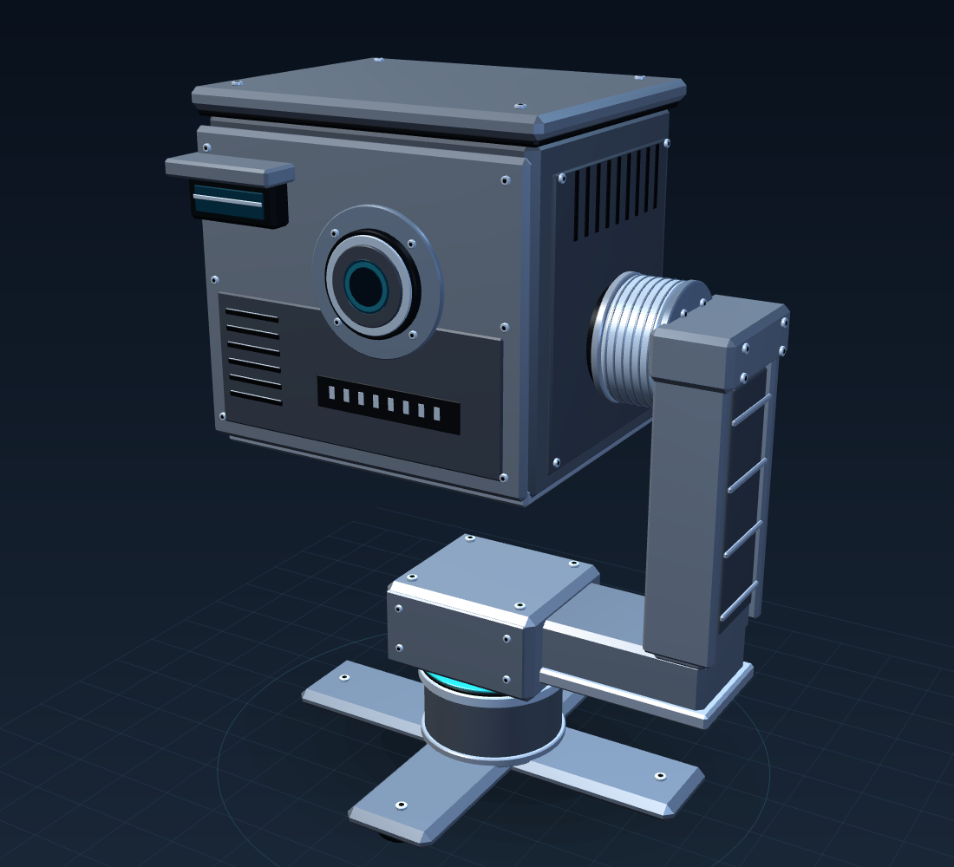
Software/Host_Software/Screenshots/model_detail_home.png
