QYS0313/FPGA_RACE_Lingmou/Software/Host_Software/Screenshots/tracking_page.png

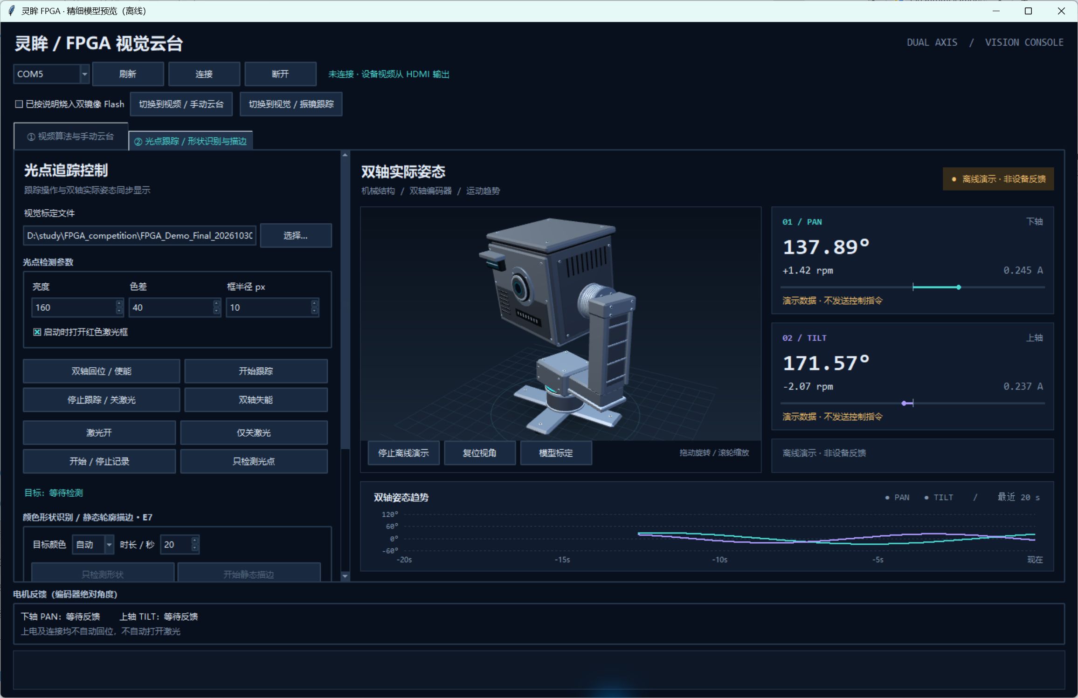
Software/Host_Software/Screenshots/tracking_page.png
