QYS0313/FPGA_RACE_Lingmou/Software/Host_Software/Screenshots/ui_atelier_video.png

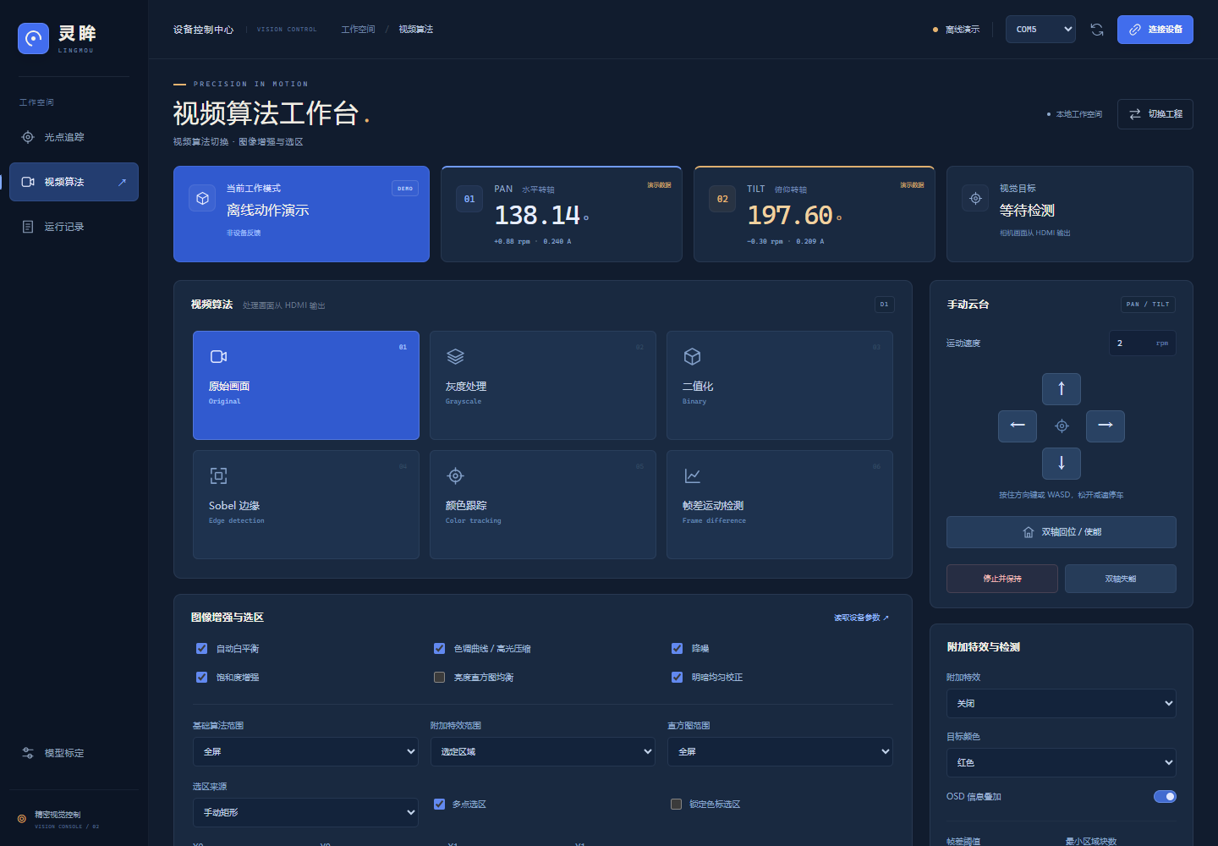
Software/Host_Software/Screenshots/ui_atelier_video.png
