QYS0313/FPGA_RACE_Lingmou/Software/Host_Software/Screenshots/ui_refined_tracking.png

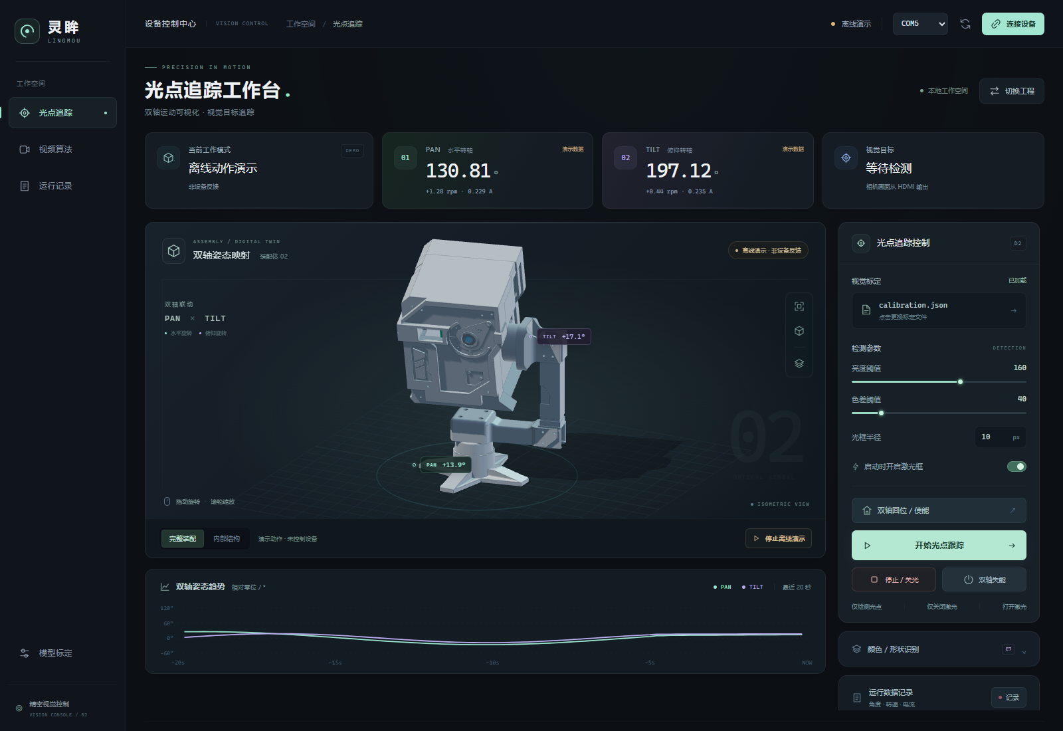
Software/Host_Software/Screenshots/ui_refined_tracking.png
