QYS0313/FPGA_RACE_Lingmou/Model/零件4.STL

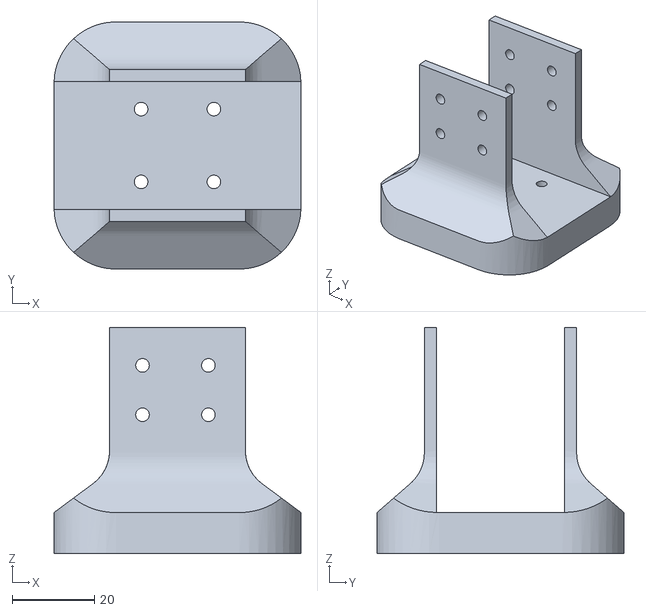
[picture p15: CAD file, 2026-11-02]
Model/零件4.STL
60.0 x 60.0 x 55.0
