QYS0313/FPGA_RACE_Lingmou/Model/零件3.STL

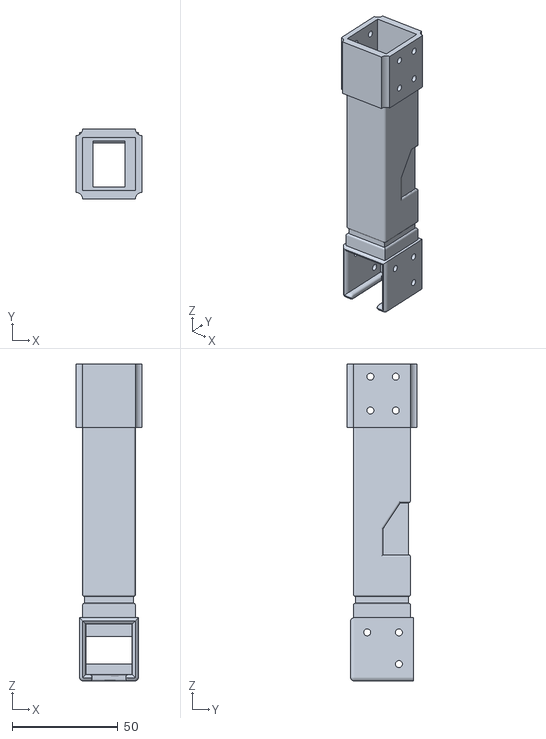
[picture p16: CAD file, 2026-11-02]
Model/零件3.STL
31.0 x 33.0 x 150.0
