QYS0313/FPGA_RACE_Lingmou/Model/零件6.STL

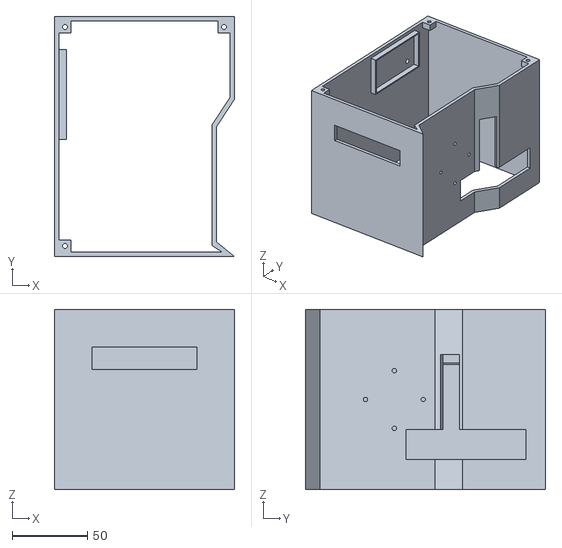
[picture p17: CAD file, 2026-11-02]
Model/零件6.STL
120.0 x 160.0 x 120.0
