QYS0313/FPGA_RACE_Lingmou/Model/零件7.STL

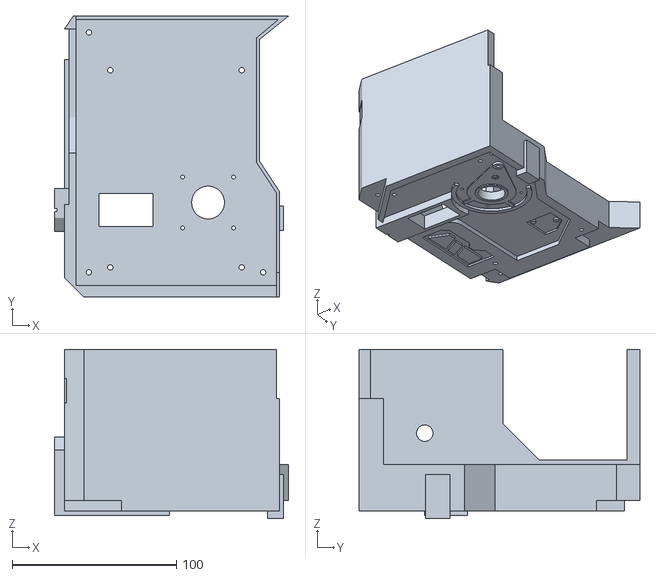
[picture p18: CAD file, 2026-11-02]
Model/零件7.STL
142.5 x 171.0 x 103.0
