QYS0313/FPGA_RACE_Lingmou/Model/零件8.STL

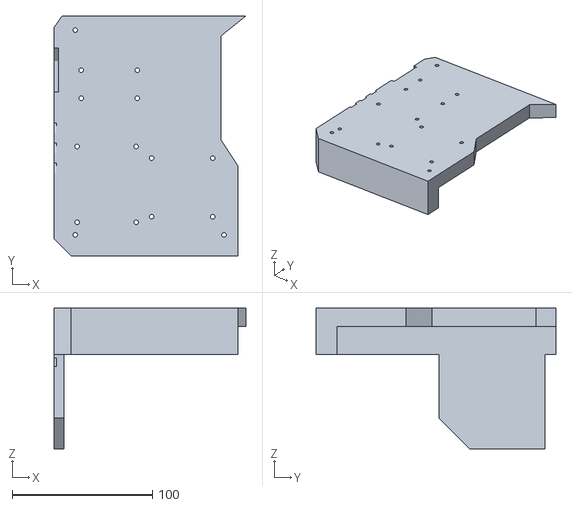
[picture p19: CAD file, 2026-11-02]
Model/零件8.STL
136.5 x 171.0 x 100.2
