QYS0313/FPGA_RACE_Lingmou/Model/零件1.STL

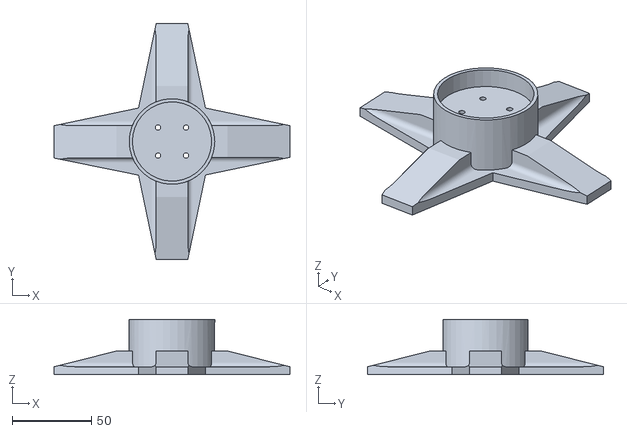
[picture p20: CAD file, 2026-11-02]
Model/零件1.STL
149.0 x 149.0 x 35.0
