QYS0313/FPGA_RACE_Lingmou/Model/零件2.STL

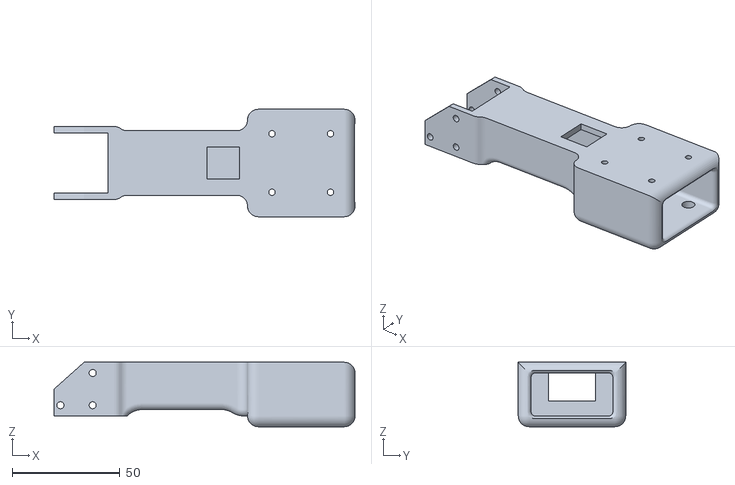
[picture p21: CAD file, 2026-11-02]
Model/零件2.STL
140.0 x 50.0 x 30.0
