QYS0313/FPGA_RACE_Lingmou/Software/FPGA_Projects/Tracking_D2/user_source/hdl_source/hdmi_mixer.v

module hdmi_mixer #(
    parameter H_OFFSET = 128,
    parameter V_OFFSET = 60,
    parameter IMG_WIDTH = 1024,
    parameter IMG_HEIGHT = 600,
    parameter integer DEBUG_MODE = 0
)(
    input wire        I_clk,
    input wire        I_rst_n,

    input wire        I_video_vsync,
    input wire        I_video_hsync,
    input wire        I_video_de,
    input wire        I_video_user,
    input wire        I_video_last,

    input wire[9:0]   I_debug_status,

    output wire       O_video_rd_en,
    input wire[23:0]  I_video_rd_data,

    output reg        O_hdmi_vsync,
    output reg        O_hdmi_hsync,
    output reg        O_hdmi_de,
    output reg[23:0]  O_hdmi_data
);

    reg        S_video_vsync_1d;
    reg        S_video_vsync_2d;
    reg        S_video_hsync_1d;
    reg        S_video_hsync_2d;
    reg        S_video_de_1d;
    reg        S_video_de_2d;
    reg [23:0] S_video_data_1d;
    reg [23:0] S_video_data_2d;
    reg [11:0] S_x;
    reg [11:0] S_y;

    assign O_video_rd_en = I_video_de;

    always @(posedge I_clk or negedge I_rst_n) begin
        if(!I_rst_n) begin
            S_x <= 12'd0;
            S_y <= 12'd0;
        end
        else if(I_video_user) begin
            S_x <= 12'd0;
            S_y <= 12'd0;
        end
        else if(I_video_de) begin
            if(I_video_last) begin
                S_x <= 12'd0;
                S_y <= S_y + 12'd1;
            end
            else begin
                S_x <= S_x + 12'd1;
            end
        end
    end

    always @(posedge I_clk or negedge I_rst_n) begin
        if(!I_rst_n) begin
            S_video_vsync_1d <= 1'b0;
            S_video_vsync_2d <= 1'b0;
            S_video_hsync_1d <= 1'b0;
            S_video_hsync_2d <= 1'b0;
            S_video_de_1d    <= 1'b0;
            S_video_de_2d    <= 1'b0;
            O_hdmi_vsync     <= 1'b0;
            O_hdmi_hsync     <= 1'b0;
            O_hdmi_de        <= 1'b0;
            O_hdmi_data      <= 24'd0;
        end
        else begin
            S_video_vsync_1d <= I_video_vsync;
            S_video_vsync_2d <= S_video_vsync_1d;
            O_hdmi_vsync     <= S_video_vsync_2d;

            S_video_hsync_1d <= I_video_hsync;
            S_video_hsync_2d <= S_video_hsync_1d;
            O_hdmi_hsync     <= S_video_hsync_2d;

            S_video_de_1d    <= I_video_de;
            S_video_de_2d    <= S_video_de_1d;
            O_hdmi_de        <= S_video_de_2d;
            S_video_data_1d  <= I_video_rd_data;
            S_video_data_2d  <= S_video_data_1d;

            if(DEBUG_MODE == 1) begin
                if(S_video_de_2d) begin
                    if(S_x < 12'd128)
                        O_hdmi_data <= 24'hff0000;
                    else if(S_x < 12'd256)
                        O_hdmi_data <= 24'h00ff00;
                    else if(S_x < 12'd384)
                        O_hdmi_data <= 24'h0000ff;
                    else if(S_x < 12'd512)
                        O_hdmi_data <= 24'hffff00;
                    else if(S_x < 12'd640)
                        O_hdmi_data <= 24'h00ffff;
                    else if(S_x < 12'd768)
                        O_hdmi_data <= 24'hff00ff;
                    else if(S_x < 12'd896)
                        O_hdmi_data <= 24'hffffff;
                    else
                        O_hdmi_data <= 24'h202020;
                end
                else begin
                    O_hdmi_data <= 24'd0;
                end
            end
            else if(DEBUG_MODE == 2) begin
                if(S_video_de_2d) begin
                    case (I_debug_status)
                        4'b0000: O_hdmi_data <= 24'h000000;
                        4'b0001: O_hdmi_data <= 24'hff0000;
                        4'b0011: O_hdmi_data <= 24'hffff00;
                        4'b0111: O_hdmi_data <= 24'h00ff00;
                        4'b1111: O_hdmi_data <= I_video_rd_data;
                        default: O_hdmi_data <= 24'h0000ff;
                    endcase
                end
                else begin
                    O_hdmi_data <= 24'd0;
                end
            end
            else if(DEBUG_MODE == 3) begin
                if(S_video_de_2d) begin
                    if(S_x < 12'd256)
                        O_hdmi_data <= I_debug_status[0] ? 24'hff8000 : 24'h201000;
                    else if(S_x < 12'd512)
                        O_hdmi_data <= I_debug_status[1] ? 24'hffff00 : 24'h202000;
                    else if(S_x < 12'd768)
                        O_hdmi_data <= I_debug_status[2] ? 24'hff0000 : 24'h200000;
                    else
                        O_hdmi_data <= I_debug_status[3] ? 24'h00ffff : 24'h002020;
                end
                else begin
                    O_hdmi_data <= 24'd0;
                end
            end
            else if(DEBUG_MODE == 4) begin
                if(S_video_de_2d) begin
                    // Preserve the live video and overlay ten 128-pixel status
                    // blocks on the first 32 lines. Green means that stage has
                    // produced activity since reset; red means it has not.
                    if(S_y < 12'd32) begin
                        if(S_x < 12'd128)
                            O_hdmi_data <= I_debug_status[0] ? 24'h00d040 : 24'hd02020;
                        else if(S_x < 12'd256)
                            O_hdmi_data <= I_debug_status[1] ? 24'h00d040 : 24'hd02020;
                        else if(S_x < 12'd384)
                            O_hdmi_data <= I_debug_status[2] ? 24'h00d040 : 24'hd02020;
                        else if(S_x < 12'd512)
                            O_hdmi_data <= I_debug_status[3] ? 24'h00d040 : 24'hd02020;
                        else if(S_x < 12'd640)
                            O_hdmi_data <= I_debug_status[4] ? 24'h00d040 : 24'hd02020;
                        else if(S_x < 12'd768)
                            O_hdmi_data <= I_debug_status[5] ? 24'h00d040 : 24'hd02020;
                        else if(S_x < 12'd896)
                            O_hdmi_data <= I_debug_status[6] ? 24'h00d040 : 24'hd02020;
                        else if(S_x < 12'd1024)
                            O_hdmi_data <= I_debug_status[7] ? 24'h00d040 : 24'hd02020;
                        else if(S_x < 12'd1152)
                            O_hdmi_data <= I_debug_status[8] ? 24'h00d040 : 24'hd02020;
                        else
                            O_hdmi_data <= I_debug_status[9] ? 24'h00d040 : 24'hd02020;
                    end
                    else begin
                        O_hdmi_data <= S_video_data_2d;
                    end
                end
                else begin
                    O_hdmi_data <= 24'd0;
                end
            end
            else begin
                O_hdmi_data <= S_video_data_2d;
            end
        end
    end

endmodule
