QYS0313/FPGA_RACE_Lingmou/Software/FPGA_Projects/Tracking_D2/user_source/hdl_source/video_out.v

module video_out (
    input wire        I_rst_n,

    input wire        I_ddr_clk,
    output wire       O_video_out_rd_busy,  
    input wire        I_video_in_wr_busy,   
    input wire[1:0]   I_video_out_rp,
    output wire       O_ddr_user_rd_en,
    output reg[24:0]  O_ddr_user_addr,
    input wire        I_ddr_user_ready,
    input wire        I_ddr_user_rd_valid,
    input wire[127:0] I_ddr_user_rd_data,

    input wire        I_dsi_clk,
    input wire        I_video_vsync,
    input wire        I_video_rd_en,  
    output reg[23:0]  O_vdieo_data,
    output reg        O_debug_frame_words_ok
);

    reg         S_fifo_rst;     
    reg[7:0]    S_fifo_rst_cnt;
    wire[8:0]   S_fifo_wr_num;       
    wire        S_fifo_rd_en;        
    wire[127:0] S_fifo_rd_data;      
    reg         S_video_vsync_1d;
    reg         S_video_vsync_2d;
    reg         S_video_vsync_3d;
    wire        S_video_frame_start;   
    wire        S_ddr_rd_trig;       
    reg         S_ddr_rd_valid;      
    reg[9:0]    S_ddr_rd_cnt;        
    reg[3:0]    S_fifo_rd_cnt;       
    reg         S_video_rd_en_1d;
    reg[3:0]    S_fifo_rd_cnt_1d;     
    reg[127:0]  S_fifo_rd_data_1d;    
	wire        S_fifo_emtpy;
    reg[18:0]  S_debug_frame_words;



    localparam IMAGE_BASE_ADDR_0 = 25'd0;
    localparam IMAGE_BASE_ADDR_1 = 25'd7000000;
    localparam IMAGE_BASE_ADDR_2 = 25'd14000000;
    localparam IMAGE_BASE_ADDR_3 = 25'd21000000;


    always @(posedge I_ddr_clk) begin
        S_video_vsync_1d <= I_video_vsync;
        S_video_vsync_2d <=S_video_vsync_1d;
        S_video_vsync_3d <= S_video_vsync_2d;
    end

    assign S_video_frame_start = ~S_video_vsync_3d & S_video_vsync_2d;


    always @(posedge I_ddr_clk or negedge I_rst_n) begin
        if(!I_rst_n)
            S_fifo_rst <= 1'b0;
        else
            if(S_video_frame_start)
                S_fifo_rst <= 1'b1;
            else if(S_fifo_rst_cnt == 'd10)
                S_fifo_rst <= 1'b0;
            else
                S_fifo_rst <= S_fifo_rst;
    end


    always @(posedge I_ddr_clk) begin
        if(S_fifo_rst)
            S_fifo_rst_cnt <= S_fifo_rst_cnt + 'd1;
        else
            S_fifo_rst_cnt <= 'd0;
    end

    /*
        这里需要注意fifo的剩余空间一定要大于将要写入的长度，因为ddr读出的时候会有至少40个时钟周期的延时，
        例如每次从ddr读出240个长度的数据，那么fifo的剩余空间最少要设为280，否则会引起fifo写满丢失数据。
    */
    // One 128-bit word carries four RGB888 pixels after packing, therefore a
    // 1280x720 frame contains exactly 230400 DDR words (A5: four 32-bit
    // pixels per word; it was 172800 with dense packing).  The old reader kept
    // launching bursts during vertical blanking after the complete frame had
    // already been prefetched.  Those surplus reads were discarded by the
    // next frame reset, wasted DDR bandwidth, and kept the frame-count status
    // block red.  Stop issuing bursts at the exact frame boundary.
    assign S_ddr_rd_trig = (('d511 - S_fifo_wr_num) >= 'd300) &&
                           (!I_video_in_wr_busy) && (!S_ddr_rd_valid) &&
                           (!S_fifo_rst) && I_rst_n &&
                           (S_debug_frame_words < 19'd230400) ? 1'b1 : 1'b0;

    /*
        fifo的深度是512，实际的深度是510，因此需要注意每次读出的长度避免为256，否则连续两次写入会引起fifo写满，丢失数据
    */
    always @(posedge I_ddr_clk or negedge I_rst_n) begin
        if(!I_rst_n)
            S_ddr_rd_valid <= 1'b0;
        else
			if(O_ddr_user_rd_en && S_ddr_rd_cnt == 'd239)
                S_ddr_rd_valid <= 1'b0;
            else if(S_ddr_rd_trig)
                S_ddr_rd_valid <= 1'b1;
            else
                S_ddr_rd_valid <= S_ddr_rd_valid;
    end

    assign O_ddr_user_rd_en = S_ddr_rd_valid & I_ddr_user_ready;

    always @(posedge I_ddr_clk) begin
        if(S_ddr_rd_valid)
            begin
                if(O_ddr_user_rd_en)
                    S_ddr_rd_cnt <= S_ddr_rd_cnt + 'd1;
                else
                    S_ddr_rd_cnt <= S_ddr_rd_cnt;
            end
        else    
            S_ddr_rd_cnt <= 'd0;
    end


    always @(posedge I_ddr_clk or negedge I_rst_n) begin
        if(!I_rst_n)
            O_ddr_user_addr <= 'd0;
        else
            if(S_video_frame_start)
                begin
                    case(I_video_out_rp)
                        'd0: O_ddr_user_addr <= IMAGE_BASE_ADDR_0;
                        'd1: O_ddr_user_addr <= IMAGE_BASE_ADDR_1;
                        'd2: O_ddr_user_addr <= IMAGE_BASE_ADDR_2;
                        'd3: O_ddr_user_addr <= IMAGE_BASE_ADDR_3;
                    endcase
                end
            else if(O_ddr_user_rd_en)
                O_ddr_user_addr <= O_ddr_user_addr + 'd8;
            else    
                O_ddr_user_addr <= O_ddr_user_addr;
    end

    
    assign O_video_out_rd_busy = S_ddr_rd_trig | S_ddr_rd_valid;

    always @(posedge I_ddr_clk or negedge I_rst_n) begin
        if(!I_rst_n) begin
            S_debug_frame_words    <= 19'd0;
            O_debug_frame_words_ok <= 1'b0;
        end else if(S_video_frame_start) begin
            O_debug_frame_words_ok <= (S_debug_frame_words == 19'd230400);
            S_debug_frame_words    <= 19'd0;
        end else if(O_ddr_user_rd_en) begin
            S_debug_frame_words <= S_debug_frame_words + 19'd1;
        end
    end


    w128_d512_fifo U_w128_d512_fifo(
        .rst        ( S_fifo_rst          ),   

        .clkw       ( I_ddr_clk           ),     
        .we         ( I_ddr_user_rd_valid ),
        .di         ( I_ddr_user_rd_data  ),
        .wrusedw    ( S_fifo_wr_num       ),
        .afull      (),
        .full_flag  (),
 
        .clkr       ( I_dsi_clk           ),
        .re         ( S_fifo_rd_en        ), 
        .dout       ( S_fifo_rd_data      ),  
        .rdusedw    (), 
        .valid      (),  
        .empty_flag ( S_fifo_emtpy        ),
        .aempty     ()
    );


   always @(posedge I_dsi_clk) begin
       if(I_video_rd_en)
           S_fifo_rd_cnt <= S_fifo_rd_cnt + 'd1;
       else
           S_fifo_rd_cnt <= 'd0;
   end

   // A5 format: four 32-bit pixels per word, so pop one word every four
   // pixels.  The FIFO output updates on the edge that ends the cycle in
   // which re is high, so the popped word is readable while cnt_1d = 0..3.
   assign S_fifo_rd_en = I_video_rd_en && (S_fifo_rd_cnt[1:0] == 2'd0);

   always @(posedge I_dsi_clk) begin
       S_video_rd_en_1d  <= I_video_rd_en;
       S_fifo_rd_cnt_1d  <= S_fifo_rd_cnt;
       S_fifo_rd_data_1d <= S_fifo_rd_data;
   end

   always @(posedge I_dsi_clk) begin
       if(S_video_rd_en_1d)
           begin
               case(S_fifo_rd_cnt_1d[1:0])
                   2'd0: O_vdieo_data <= S_fifo_rd_data[119:96];
                   2'd1: O_vdieo_data <= S_fifo_rd_data[87:64];
                   2'd2: O_vdieo_data <= S_fifo_rd_data[55:32];
                   2'd3: O_vdieo_data <= S_fifo_rd_data[23:0];
               endcase
           end
       else
           O_vdieo_data <= 'd0;
   end

    
endmodule
