QYS0313/FPGA_RACE_Lingmou/Software/FPGA_Projects/Tracking_D2/user_source/hdl_source/uics500_cfg/SC500GainTbl.v

`timescale 1ns / 1ps
//////////////////////////////////////////////////////////////////////////////////
// Create Date:    01:32:02 06/12/2023 
// Module Name:    SC500GainTbl 
//////////////////////////////////////////////////////////////////////////////////
module SC500GainTbl(
	input 			I_clk,
	input 			I_rstn,
	input 	[6:0] 	I,
	output reg	[15:0] 	O
);

	always @(posedge I_clk) begin
		O <= 0; 
		case (I)
			0:O<=16'h0320; 1:O<=16'h0321; 2:O<=16'h0322; 3:O<=16'h0323; 4:O<=16'h0324; 5:O<=16'h0325; 6:O<=16'h0326; 7:O<=16'h0327; 8:O<=16'h0328; 9:O<=16'h0329; 10:O<=16'h032A; 11:O<=16'h032B; 12:O<=16'h032C; 13:O<=16'h032D; 14:O<=16'h032E; 15:O<=16'h032F; 
			16:O<=16'h0330; 17:O<=16'h0331; 18:O<=16'h0332; 19:O<=16'h0333; 20:O<=16'h0334; 21:O<=16'h0335; 22:O<=16'h0336; 23:O<=16'h0337; 24:O<=16'h0338; 25:O<=16'h0339; 26:O<=16'h033A; 27:O<=16'h033B; 28:O<=16'h033C; 29:O<=16'h033D; 30:O<=16'h033E; 31:O<=16'h033F; 
			32:O<=16'h0720; 33:O<=16'h0721; 34:O<=16'h0722; 35:O<=16'h0723; 36:O<=16'h0724; 37:O<=16'h0725; 38:O<=16'h0726; 39:O<=16'h0727; 40:O<=16'h0728; 41:O<=16'h0729; 42:O<=16'h072A; 43:O<=16'h072B; 44:O<=16'h072C; 45:O<=16'h072D; 46:O<=16'h072E; 47:O<=16'h072F; 
			48:O<=16'h0730; 49:O<=16'h0731; 50:O<=16'h0732; 51:O<=16'h0733; 52:O<=16'h0734; 53:O<=16'h0735; 54:O<=16'h0736; 55:O<=16'h0737; 56:O<=16'h0738; 57:O<=16'h0739; 58:O<=16'h073A; 59:O<=16'h073B; 60:O<=16'h073C; 61:O<=16'h073D; 62:O<=16'h073E; 63:O<=16'h073F; 
			64:O<=16'h0F20; 65:O<=16'h0F21; 66:O<=16'h0F22; 67:O<=16'h0F23; 68:O<=16'h0F24; 69:O<=16'h0F25; 70:O<=16'h0F26; 71:O<=16'h0F27; 72:O<=16'h0F28; 73:O<=16'h0F29;
			// A6: remaining entries from SC500CS datasheet table 2-4 (V1.8 p.24-25).
			// 0x0F2A..0x0F3F = 5.25x..7.875x, 0x1F20..0x1F3F = 8x..15.75x.
			74:O<=16'h0F2A; 75:O<=16'h0F2B; 76:O<=16'h0F2C; 77:O<=16'h0F2D; 78:O<=16'h0F2E; 79:O<=16'h0F2F; 80:O<=16'h0F30; 81:O<=16'h0F31; 82:O<=16'h0F32; 83:O<=16'h0F33; 84:O<=16'h0F34; 85:O<=16'h0F35; 86:O<=16'h0F36; 87:O<=16'h0F37; 88:O<=16'h0F38; 89:O<=16'h0F39;
			90:O<=16'h0F3A; 91:O<=16'h0F3B; 92:O<=16'h0F3C; 93:O<=16'h0F3D; 94:O<=16'h0F3E; 95:O<=16'h0F3F;
			96:O<=16'h1F20; 97:O<=16'h1F21; 98:O<=16'h1F22; 99:O<=16'h1F23; 100:O<=16'h1F24; 101:O<=16'h1F25; 102:O<=16'h1F26; 103:O<=16'h1F27; 104:O<=16'h1F28; 105:O<=16'h1F29; 106:O<=16'h1F2A; 107:O<=16'h1F2B; 108:O<=16'h1F2C; 109:O<=16'h1F2D; 110:O<=16'h1F2E; 111:O<=16'h1F2F;
			112:O<=16'h1F30; 113:O<=16'h1F31; 114:O<=16'h1F32; 115:O<=16'h1F33; 116:O<=16'h1F34; 117:O<=16'h1F35; 118:O<=16'h1F36; 119:O<=16'h1F37; 120:O<=16'h1F38; 121:O<=16'h1F39; 122:O<=16'h1F3A; 123:O<=16'h1F3B; 124:O<=16'h1F3C; 125:O<=16'h1F3D; 126:O<=16'h1F3E; 127:O<=16'h1F3F;
		endcase
	end

endmodule
