QYS0313/FPGA_RACE_Lingmou/Software/FPGA_Projects/Tracking_D2/user_source/hdl_source/contest_region_fx.v

`timescale 1ns / 1ps

// A20: effects applied inside a rectangular region of the TRACK-mode video.
//
// The region is supplied by the tracker: either the largest target box or
// the union of all detected boxes (up to four same-colour markers, e.g. tape
// on the fingertips framing a "viewfinder").  Inside the region one of the
// following is applied; outside, the video passes through.
//
//   fx_mode 0: off (tracker draws its usual boxes)
//   fx_mode 1: outline only
//   fx_mode 2: mosaic (pixelate, block size 8/16/32 selected by mosaic_sel)
//   fx_mode 3: cartoon (colour posterised to 4 levels per channel, Sobel
//              edges drawn black)
//   fx_mode 4: sticker (A35): a 320x180, 256-colour picture stored on chip is
//              shown 4x upscaled behind the region -- the region is a window onto it
//   fx_mode 5: blue negative (A24: luma inverted, mapped to a blue palette:
//              deep blue shadows, teal midtones, white where the picture was dark)
//
// Three-clock pipeline (A35: index ROM read, palette read, output), so the
// video timing is delayed by the same three clocks.
module contest_region_fx #(
    parameter integer IMAGE_WIDTH = 1280
) (
    input  wire        clk,
    input  wire        rst_n,
    input  wire        in_vsync,
    input  wire        in_hsync,
    input  wire        in_de,
    input  wire [23:0] in_rgb,          // tracker output (boxes suppressed by the tracker when fx is on)
    input  wire [23:0] clean_rgb,       // same timing, no overlays
    input  wire        in_edge,         // Sobel edge flag, same timing
    input  wire        enable,          // TRACK mode active
    input  wire [2:0]  fx_mode,
    input  wire [1:0]  mosaic_sel,      // 0: 8 px, 1: 16 px, 2: 32 px
    input  wire        region_valid,
    input  wire [11:0] region_x0,
    input  wire [11:0] region_y0,
    input  wire [11:0] region_x1,       // inclusive
    input  wire [11:0] region_y1,
    output reg         out_vsync,
    output reg         out_hsync,
    output reg         out_de,
    output reg  [23:0] out_rgb,
    output reg  [23:0] out_clean       // clean_rgb delayed to out_rgb timing (for the PiP capture)
);
    // ---------------------------------------------------------------- timing
    reg [11:0] x, y;
    reg        de_d;
    always @(posedge clk or negedge rst_n) begin
        if (!rst_n) begin
            x <= 12'd0; y <= 12'd0; de_d <= 1'b0;
        end else begin
            de_d <= in_de;
            if (in_vsync) begin
                x <= 12'd0; y <= 12'd0;
            end else if (in_de) begin
                x <= de_d ? x + 12'd1 : 12'd0;
            end else if (de_d) begin
                y <= y + 12'd1;
            end
        end
    end

    // Region and mode are latched at frame start so a frame never mixes.
    reg        f_valid, f_active;
    reg [2:0]  f_mode;
    reg [1:0]  f_msel;
    reg [11:0] f_x0, f_y0, f_x1, f_y1;
    reg        vsync_d;
    always @(posedge clk or negedge rst_n) begin
        if (!rst_n) begin
            f_valid <= 1'b0; f_active <= 1'b0; f_mode <= 3'd0; f_msel <= 2'd1;
            f_x0 <= 12'd0; f_y0 <= 12'd0; f_x1 <= 12'd0; f_y1 <= 12'd0; vsync_d <= 1'b0;
        end else begin
            vsync_d <= in_vsync;
            if (in_vsync && !vsync_d) begin
                f_valid  <= region_valid;
                f_active <= enable && (fx_mode != 3'd0);
                f_mode   <= fx_mode;
                f_msel   <= mosaic_sel;
                f_x0 <= region_x0; f_y0 <= region_y0; f_x1 <= region_x1; f_y1 <= region_y1;
            end
        end
    end

    wire rect_in  = (x >= f_x0) && (x <= f_x1) && (y >= f_y0) && (y <= f_y1);
    wire inside   = in_de && f_active && f_valid && rect_in;

    // Outline (A34): a pixel is on the boundary when its inside/outside state
    // differs from the pixel two columns to the left or from the pixel in the
    // row above (one 1-bit line buffer).  Works for the rectangular region
    // alike and draws a ~2 px line on both sides of the boundary.
    (* ram_style = "bram" *) reg ins_lb [0:2047];
    reg        ins_up, ins_l1, ins_l2;
    reg [11:0] x_w;
    reg        de_w, ins_w;
    always @(posedge clk) begin
        if (in_de) begin
            ins_up <= ins_lb[x];
            ins_l1 <= inside; ins_l2 <= ins_l1;
        end
        x_w <= x; de_w <= in_de; ins_w <= inside;
        if (de_w) ins_lb[x_w] <= ins_w;
    end
    wire outline = in_de && f_active && f_valid && ((inside ^ ins_up) || (inside ^ ins_l2));
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
