QYS0313/FPGA_RACE_Lingmou/(commit log)

2026-11-02 Initial commit: FPGA projects and host software
    [.m_params_MCU.txt, .m_params_PLL.txt, .m_params_blk_mem_gen_awb_delay_signal.txt, .m_params_blk_mem_gen_demosaic.txt, .m_params_blk_mem_gen_zhenghe.txt, .m_params_ddr2.txt, .m_params_w128_d512_fifo.txt, .m_params_w155_d512_fifo.txt]
2026-11-02 Add mechanical model STL files
    [零件1.STL, 零件2.STL, 零件3.STL, 零件4.STL, 零件6.STL, 零件7.STL, 零件8.STL]
